DStageGarage/WBOOS/WBOOS v1.2/DStage_WBOOS_v1.2_schematic.pdf

# DStage WBOOS v1.2 2025.01.28

# (14point7 SLC Free tribute)

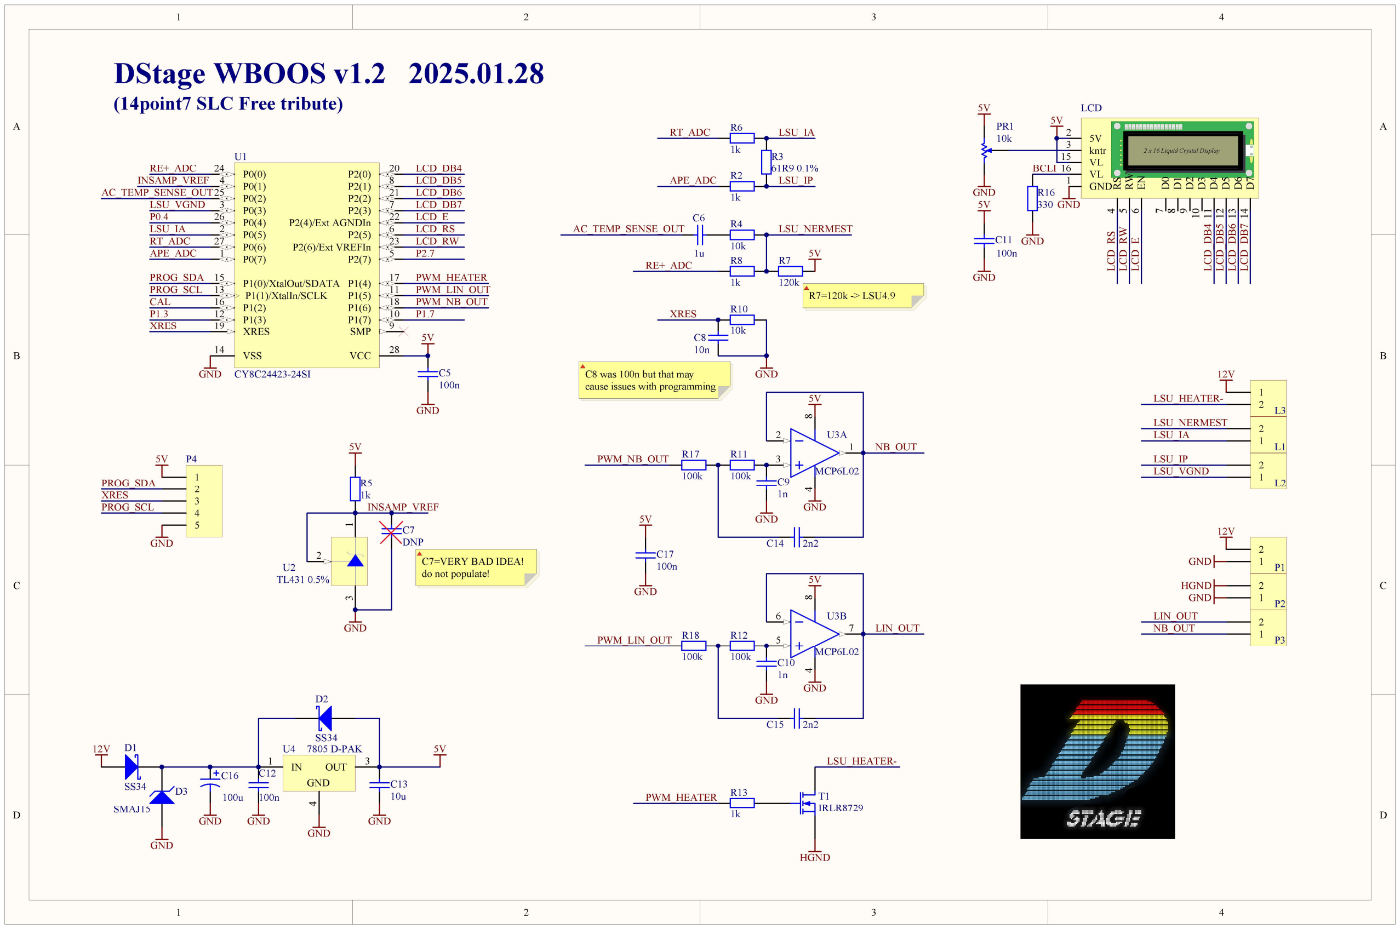
[picture p5: page 1]

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
P0(3) 3

P0(1) 4

P1(1)/XtalIn/SCLK 13 P1(0)/XtalOut/SDATA 15

P0(0) 24

P0(2) 25

VSS 14 | VCC | 28

P0(7) 1

P0(5) 2
P0(6) 27

P0(4) 26

P1(2) 16
P1(3) 12
P1(5) | 11
P1(6) | 18
P1(7) | 10
P1(4) | 17
SMP | 9 XRES 19
P2(1) | 8
P2(0) | 20
P2(2) | 21
P2(3) | 7
P2(5) | 6
P2(6)/Ext VREFIn | 23
P2(7) | 5
P2(4)/Ext AGNDIn | 22

U1

CY8C24423-24SI

RE+_ADC

5V

GND

APE_ADC

LSU_IA

LSU_VGND

INSAMP_VREF

P2.7

LCD_RS

LCD_DB7

LCD_DB5

P1.7

PWM_LIN_OUT

P1.3

PROG_SCL

PROG_SDA

CAL

PWM_HEATER

PWM_NB_OUT

XRES

LCD_DB4

LCD_DB6

LCD_E

LCD_RW

AC_TEMP_SENSE_OUT

P0.4

RT_ADC

APE_ADC

1u

C6

1k

R2 | 61R9 0.1% R3
| LSU_IP

10k

R4

10k

R10

AC_TEMP_SENSE_OUT | LSU_NERMEST

1k

R8 RE+_ADC

120k

R7 5V

XRES

10n

C8

GND

100k

R11

1n

C9

GND

NB_OUT
PWM_NB_OUT

100n

C5

GND

100k

R12

DNP

C7

PWM_LIN_OUT

LIN_OUT

1k

R5

GND

5V

INSAMP_VREF

1k

R13 PWM_HEATER

1n

C10

GND

1k

R6 RT_ADC | LSU_IA

### 2 x 16 Liquid Crystal Display RS

### 4 RW 5 EN 6 D0

### 7 D1

### 8 D2

### 9 D3 10 D4 11 D5 12 D6 13 D7 14

VL 15
VL 16
GND 1

5V 2
kntr 3

LCD
5V

GND

5V

GND

BCLI

100n

C11

GND

10k

PR1

5V | 330 R16
GND | LCD_RS LCD_RW LCD_E | LCD_DB⁴ LCD_DB⁵ LCD_DB⁶ LCD_DB⁷

1

2
L1

1

2
L2

1

### 2 L3

LSU_NERMEST
LSU_IA

LSU_IP
LSU_VGND

LSU_HEATER-

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
HGND
GND
LIN_OUT
NB_OUT

T1
IRLR8729

LSU_HEATER-

HGND

2 3 1 U2

TL431 0.5%

100k

R17

100k

R18

3

2

### 1 ⁸ 4

U3A

MCP6L02

5

6

### 7 ⁸ 4

U3B

MCP6L02

IN 1 | 4
OUT | 3

GND

U4 7805 D-PAK

GND

12V D1

SS34
100n

C12

10u

C13

GND | GND

5V

D2

SS34

C14 2n2 GND

5V

GND

5V

C15 2n2

D3
SMAJ15

GND

100u

C16

GND

12V

100n

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
PROG_SCL

PROG_SDA
XRES

GND

5V

R7=120k -> LSU4.9

C7=VERY BAD IDEA!
do not populate!

C8 was 100n but that may
cause issues with programming
