DStageGarage/WBOOS/WBOOS v1.2/DStage_WBOOS_v1.2_BOM.xlsx

Comment | Designator | Footprint | JLCPCB part #
100n | C5, C11, C12, C17 | C0805 | C28233
1u | C6 | C0805 | C28323
10n | C8 | C0805 | C1710
1n | C9, C10 | C0805 | C46653
10u | C13 | C0805 | C15850
2n2 | C14, C15 | C0805 | C28260
100u | C16 | C0805 | C7223
SS34 | D1, D2 | SMA | C8678
SMAJ15 | D3 | SMA | C353478
Header | L1, L2, L3, P1, P2, P3 | ARK2
LCD 2x1 | LCD | 16pin
Header | P4 | 5pin
10k POT | PR1 | SMD-3_3.0x3.8x1.2 | C719176
1k | R2, R5, R6, R8, R13 | R0805 | C17513
61R9 | R3 | R0805 | C104439
10k | R4, R10 | R0805 | C17414
120k | R7 | R0805 | C25808
100k | R11, R12, R17, R18 | R0805 | C149504
330R | R16 | R0805 | C17630
IRLR8729 | T1 | D-Pak | C5357578
CY8C24423 | U1 | SSOP28 | C2953650
TL431 | U2 | SOT-23 | C41283
MCP6002 | U3 | SO8 | C7377
78M05 | U4 | D-Pak | C110908
