DStageGarage/WBOOS/WBOOS 3D printed case/WBOOS front v1.0.stl

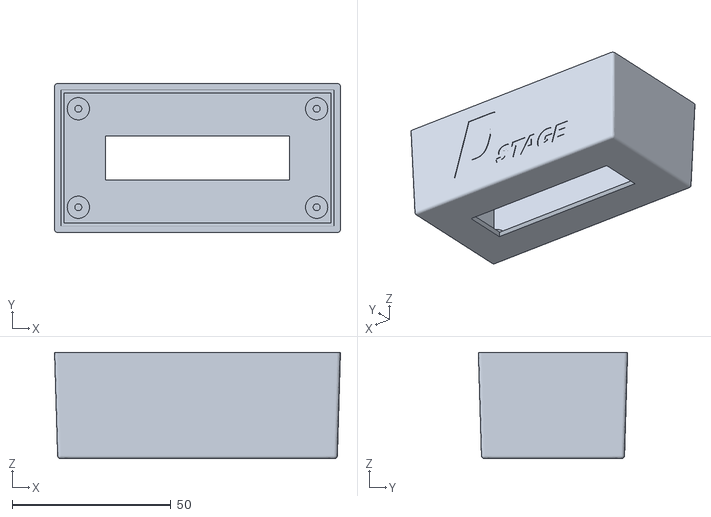
[picture p6: CAD file, 2022-03-22]
WBOOS 3D printed case/WBOOS front v1.0.stl
90.0 x 47.0 x 33.5
