DStageGarage/WBOOS/(list of files, cad)

Other CAD files:
WBOOS 3D printed case/WBOOS front v1.0.f3d
