DStageGarage/WBOOS/WBOOS v1.1/WBOOS v1.0 Schematic.pdf

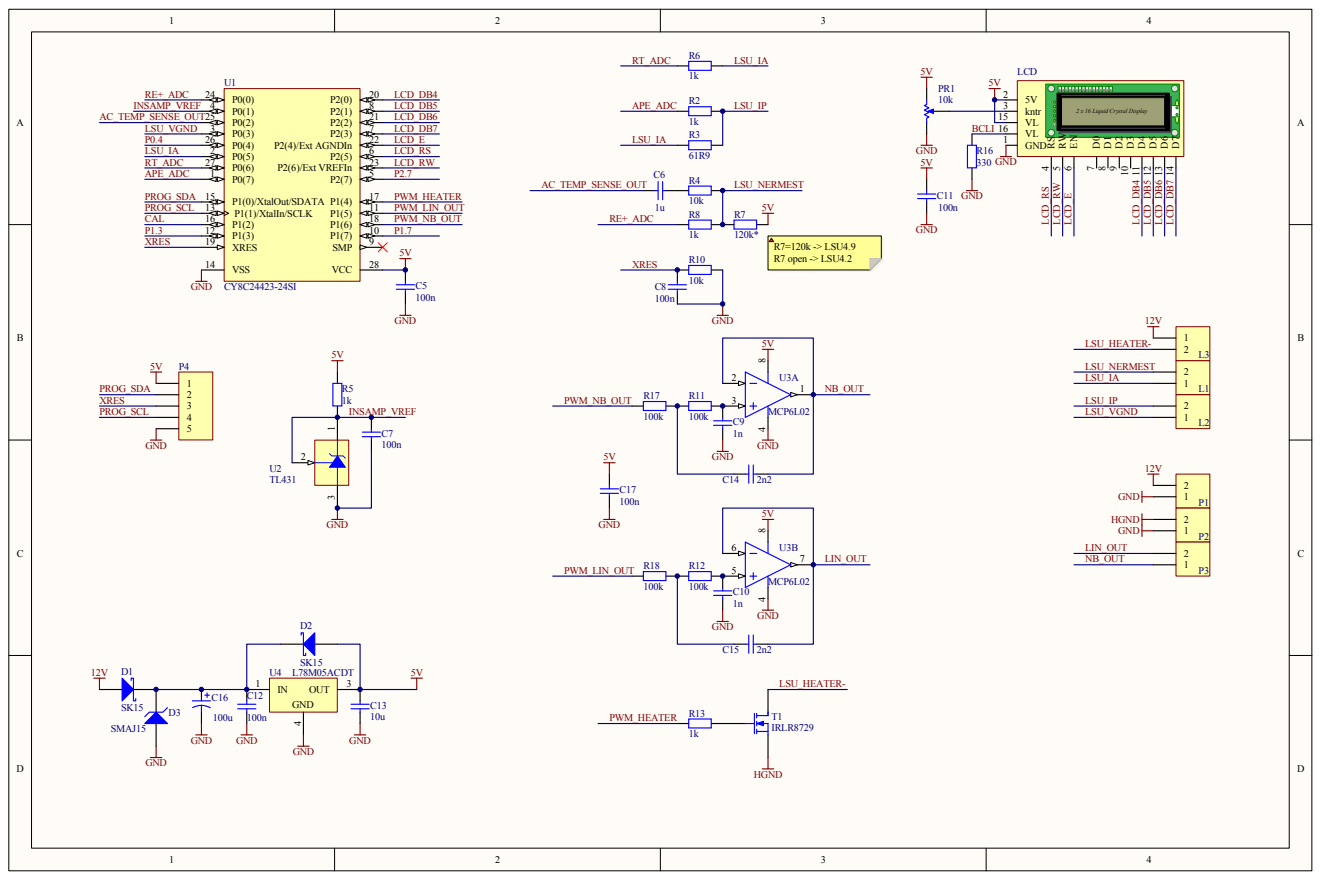
[picture p7: page 1]
