DStageGarage/WBOOS/WBOOS v1.1/WBOOS v1.0 PCB.pdf

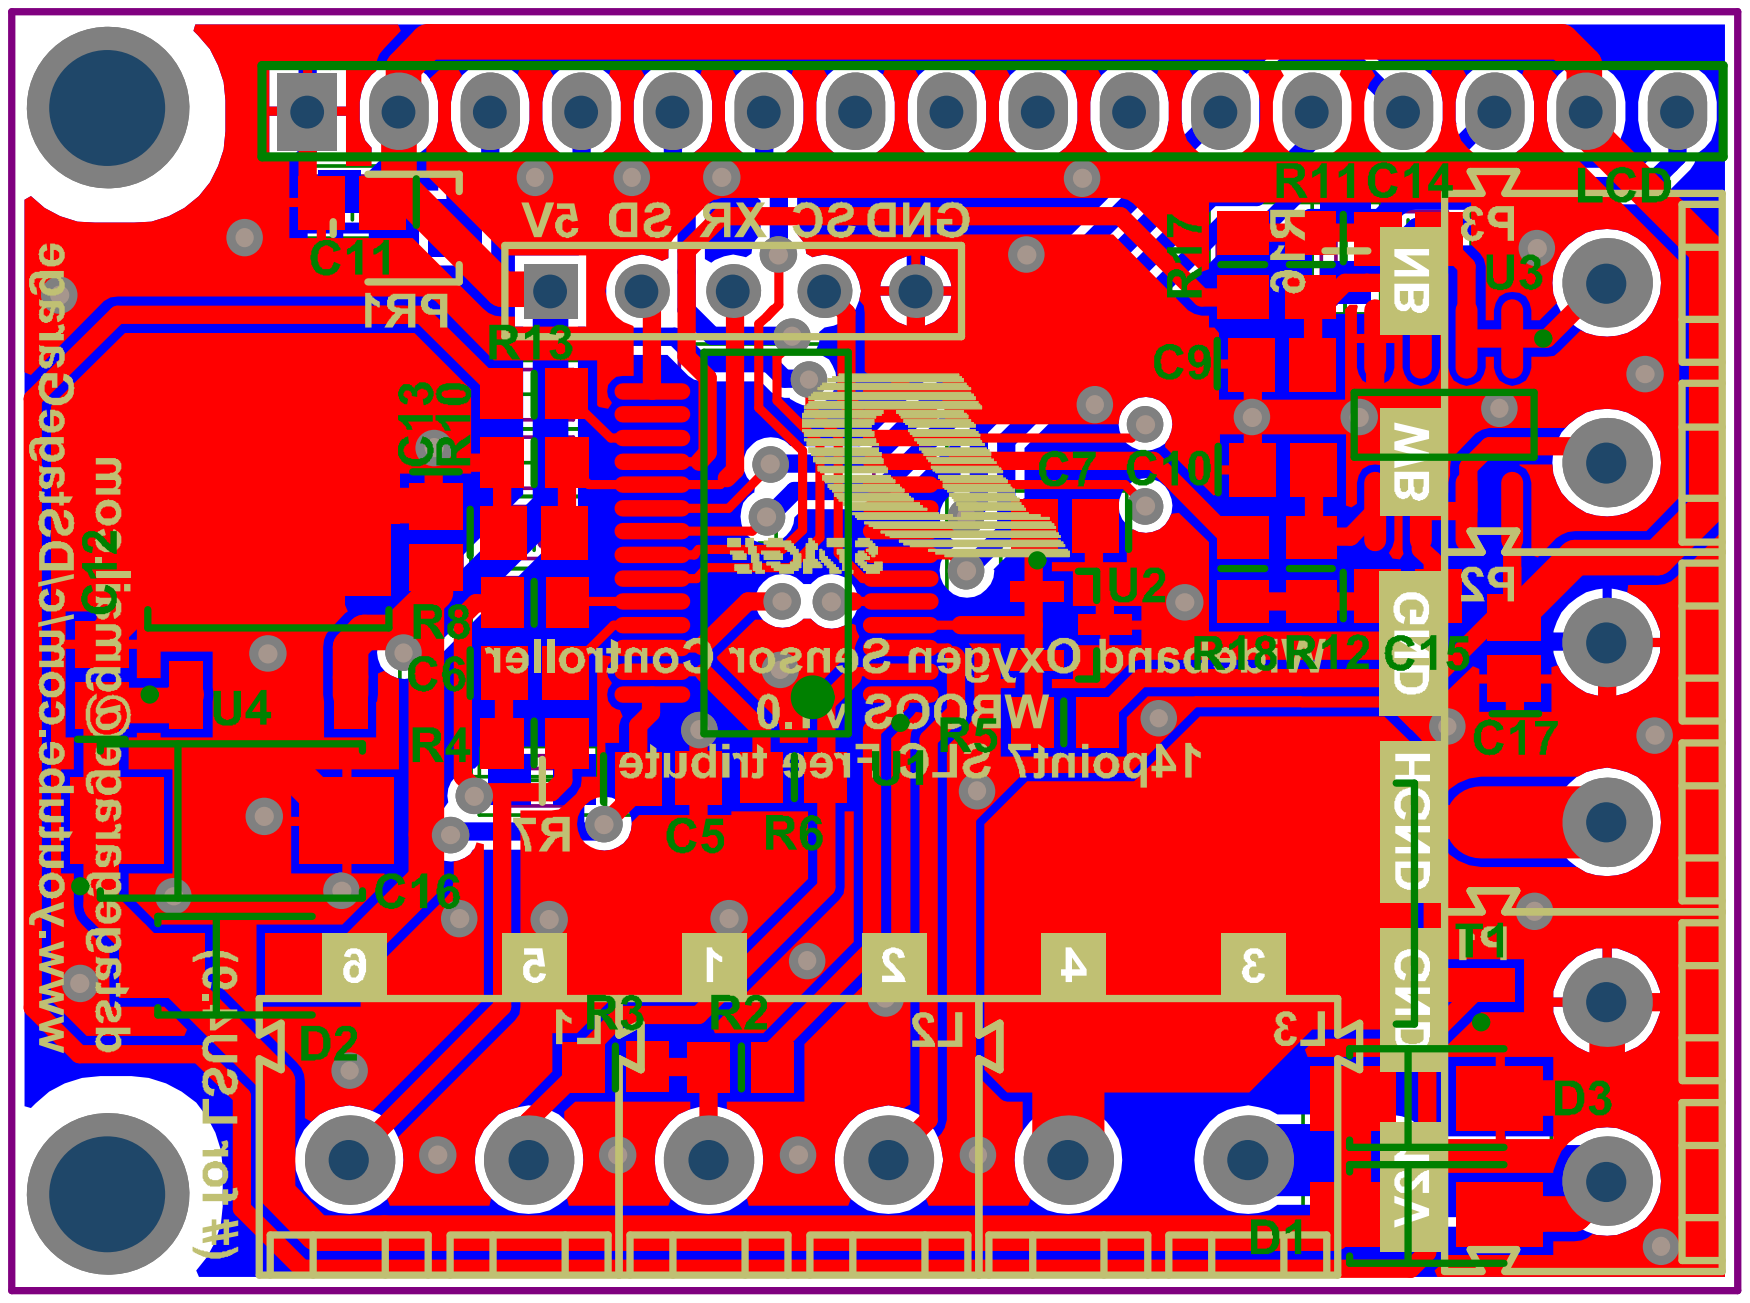
[picture p8: page 1]
