DStageGarage/WBOOS/(commit log)

2022-03-22 Added SW, gerbers, schematic and simple BOM
    [WBOOS_bom.xls]
2022-03-22 Added 3D printed case project and front stl
    [WBOOS front v1.0.f3d, WBOOS front v1.0.stl]
2022-11-14 Gerbers - clear file name now
2022-11-14 Sample photos
2025-01-25 WBOOS v1.2 added
    [DStage_WBOOS_v1.2_BOM.xlsx, WBOOS_bom.xls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]
2025-01-28 Changed C8 value in BOM
    [DStage_WBOOS_v1.2_BOM.xlsx]
2025-01-28 schematic added
2026-02-22 Update README with analogue outputs info
    Added details about analogue outputs and improved LED display description.
